jbeuckm/Mike-Sims-VCA/eagle/mike_sims_vca.png

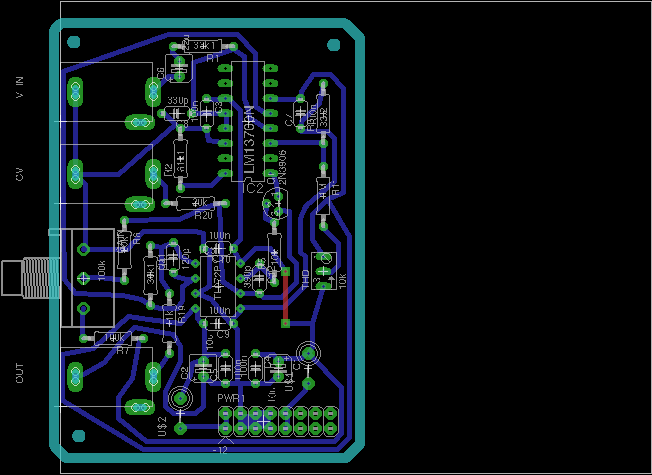
eagle/mike_sims_vca.png
