jbeuckm/Mike-Sims-VCA/panel/mike_sims_vca_panel.dxf

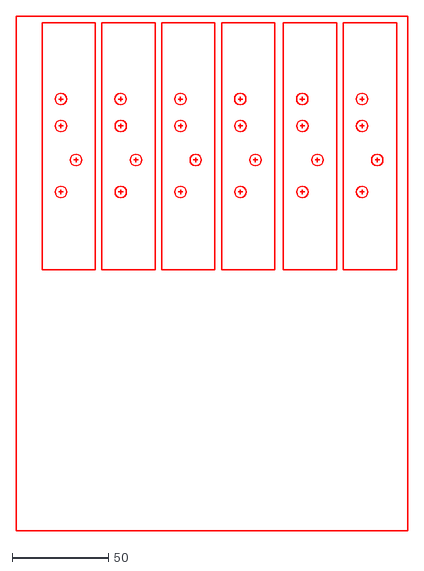
[picture p2: CAD file, 2016-01-24]
panel/mike_sims_vca_panel.dxf
203.2 x 267.2
