jbeuckm/Mike-Sims-VCA/panel/mike_sims_vca_panel.pdf

in

# VCA

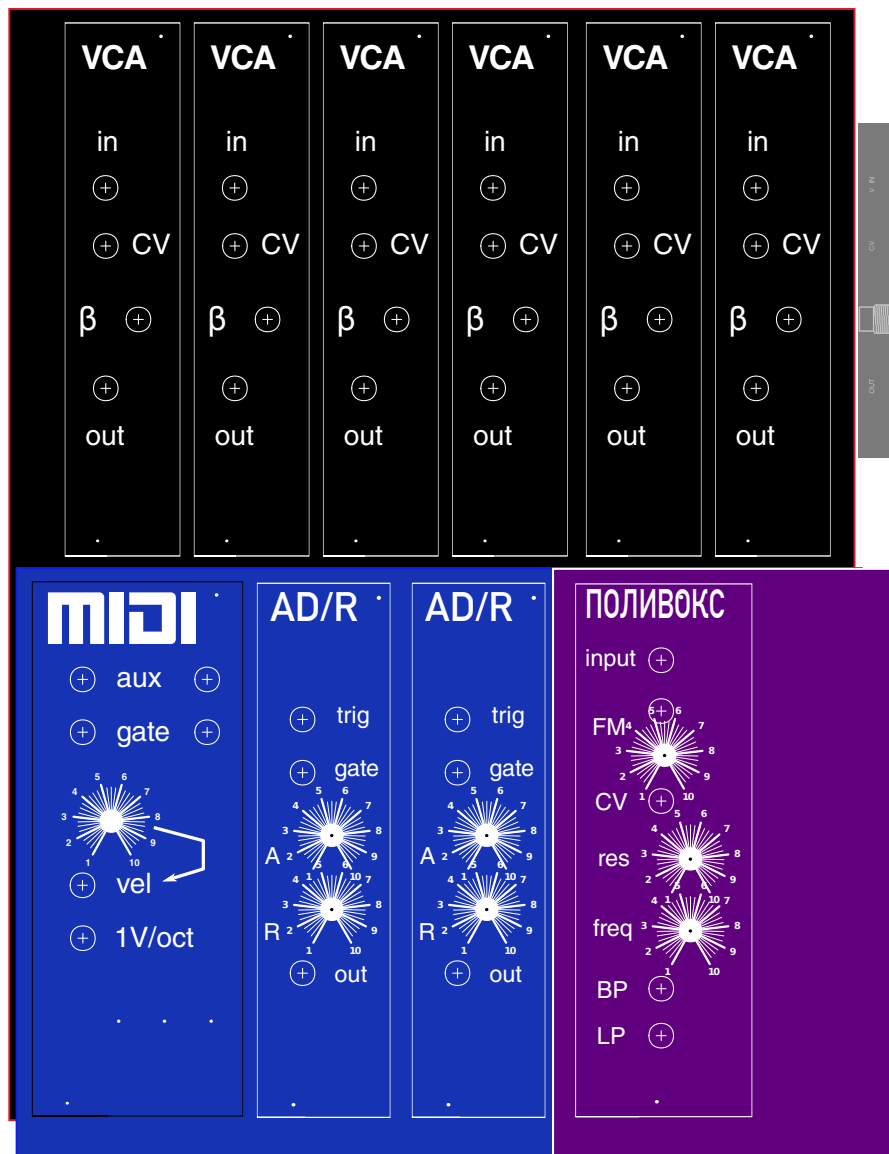
[picture p3: page 1]
out; VCA; vel; 1V/oct; gate; aux; trig; ПОЛИВОКС; input; res; freq
