jbeuckm/Mike-Sims-VCA/eagle/mike_sims_vca.sch

## EAGLE design eagle/mike_sims_vca.sch (2016-01-22)

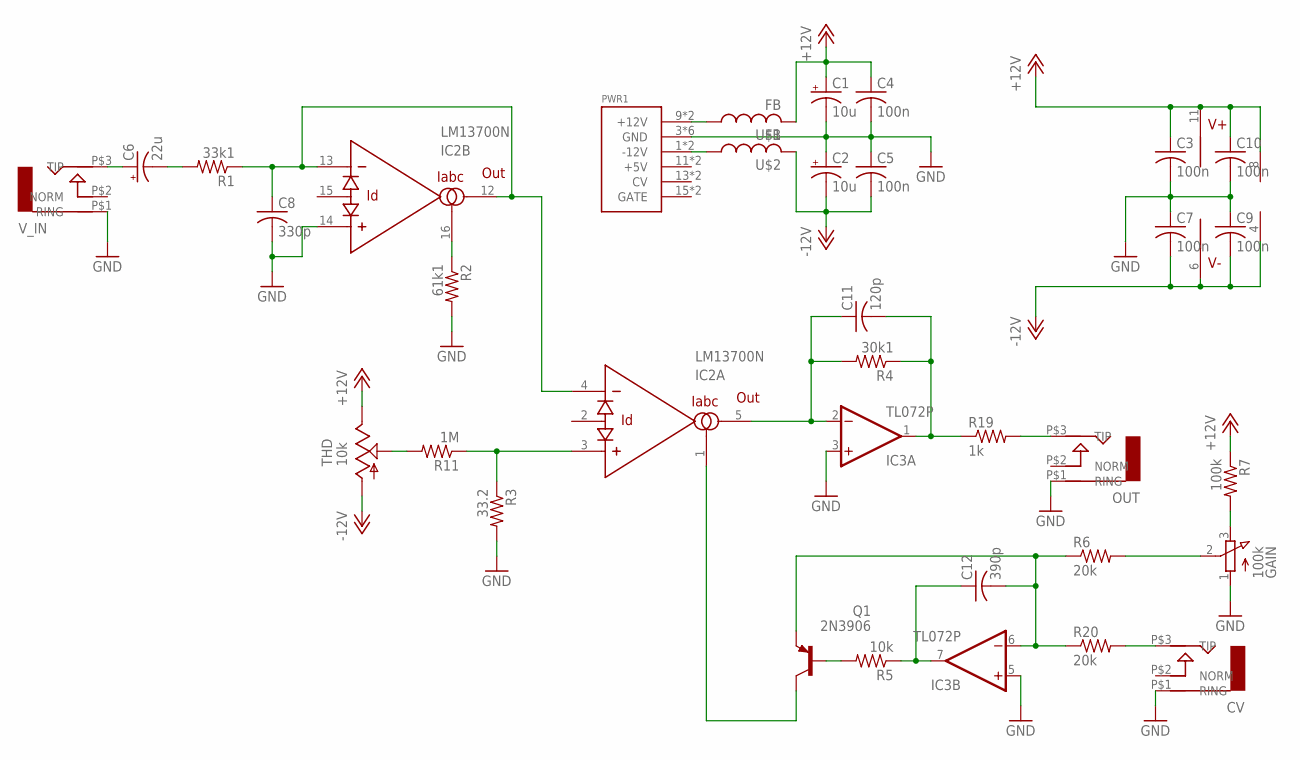
[picture p4: schematic mike_sims_vca.sch]

Parts:
C1, C2: 10u; B45181A
C3, C4, C5, C7, C9, C10: 100n; C050-024X044
C6: 22u; B45181A
C8: 330p; C050-024X044
C11: 120p; C050-024X044
C12: 390p; C050-024X044
CV: AUDIO-JACK; ERTHENVAR-JACK-90DEG
GAIN: 100k; 3RP/1610N
IC2: LM13700N; DIL16
IC3: TL072P; DIL08
OUT: AUDIO-JACK; ERTHENVAR-JACK-90DEG
PWR1: POWER; POWER_16
Q1: 2N3906; TO92
R1: 33k1; 0207/10
R2: 61k1; 0207/10
R3: 33.2; 0207/10
R4: 30k1; 0207/10
R5: 10k; 0207/10
R6, R20: 20k; 0207/10
R7: 100k; 0207/10
R11: 1M; 0207/10
R19: 1k; 0207/10
THD: 10k; B64Y
U$1, U$2: FB
V_IN: AUDIO-JACK; ERTHENVAR-JACK-90DEG

Connections:
+12V: C1.+, C3.1, C4.1, C10.1, IC2.11 (V+), IC3.8 (V+), R7.1, THD.E, U$1.P$2 (2)
-12V: C2.-, C5.2, C7.2, C9.2, IC2.6 (V-), IC3.4 (V-), THD.A, U$2.P$2 (2)
GND: C1.-, C2.+, C3.2, C4.2, C5.1, C7.1, C8.2, C9.1, C10.2, CV.P$1 (RING), GAIN.1 (A), IC2.14 (+IN), IC3.3 (+IN), IC3.5 (+IN), OUT.P$1 (RING), PWR1.3 (GND), R2.2, R3.2, V_IN.P$1 (RING)
unnamed: PWR1.9 (+12V), U$1.P$1 (1)
unnamed: PWR1.1 (-12V), U$2.P$1 (1)
unnamed: C6.+, V_IN.P$3 (TIP)
unnamed: C6.-, R1.2
unnamed: C8.1, IC2.4 (-IN), IC2.12 (OUT), IC2.13 (-IN), R1.1
unnamed: IC2.3 (+IN), R3.1, R11.1
unnamed: IC2.16 (IABC), R2.1
unnamed: C11.2, IC3.1 (OUT), R4.1, R19.1
unnamed: C11.1, IC2.5 (OUT), IC3.2 (-IN), R4.2
unnamed: Q1.2 (B), R5.2
unnamed: C12.1, IC3.7 (OUT), R5.1
unnamed: GAIN.2 (S), R6.2
unnamed: GAIN.3 (E), R7.2
unnamed: R11.2, THD.S
unnamed: C12.2, IC3.6 (-IN), Q1.3 (E), R6.1, R20.1
unnamed: IC2.1 (IABC), Q1.1 (C)
unnamed: OUT.P$3 (TIP), R19.2
unnamed: CV.P$3 (TIP), R20.2
