jbeuckm/Mike-Sims-VCA/(commit log)

2016-01-20 nearly routed
    [mike_sims_vca.brd, mike_sims_vca.sch]
2016-01-21 moved to vertical
    [mike_sims_vca.brd]
